etf-lth/nolleblink/2013/hw/nolleblink2013.brd

## EAGLE design 2013/hw/nolleblink2013.brd (2013-07-16)

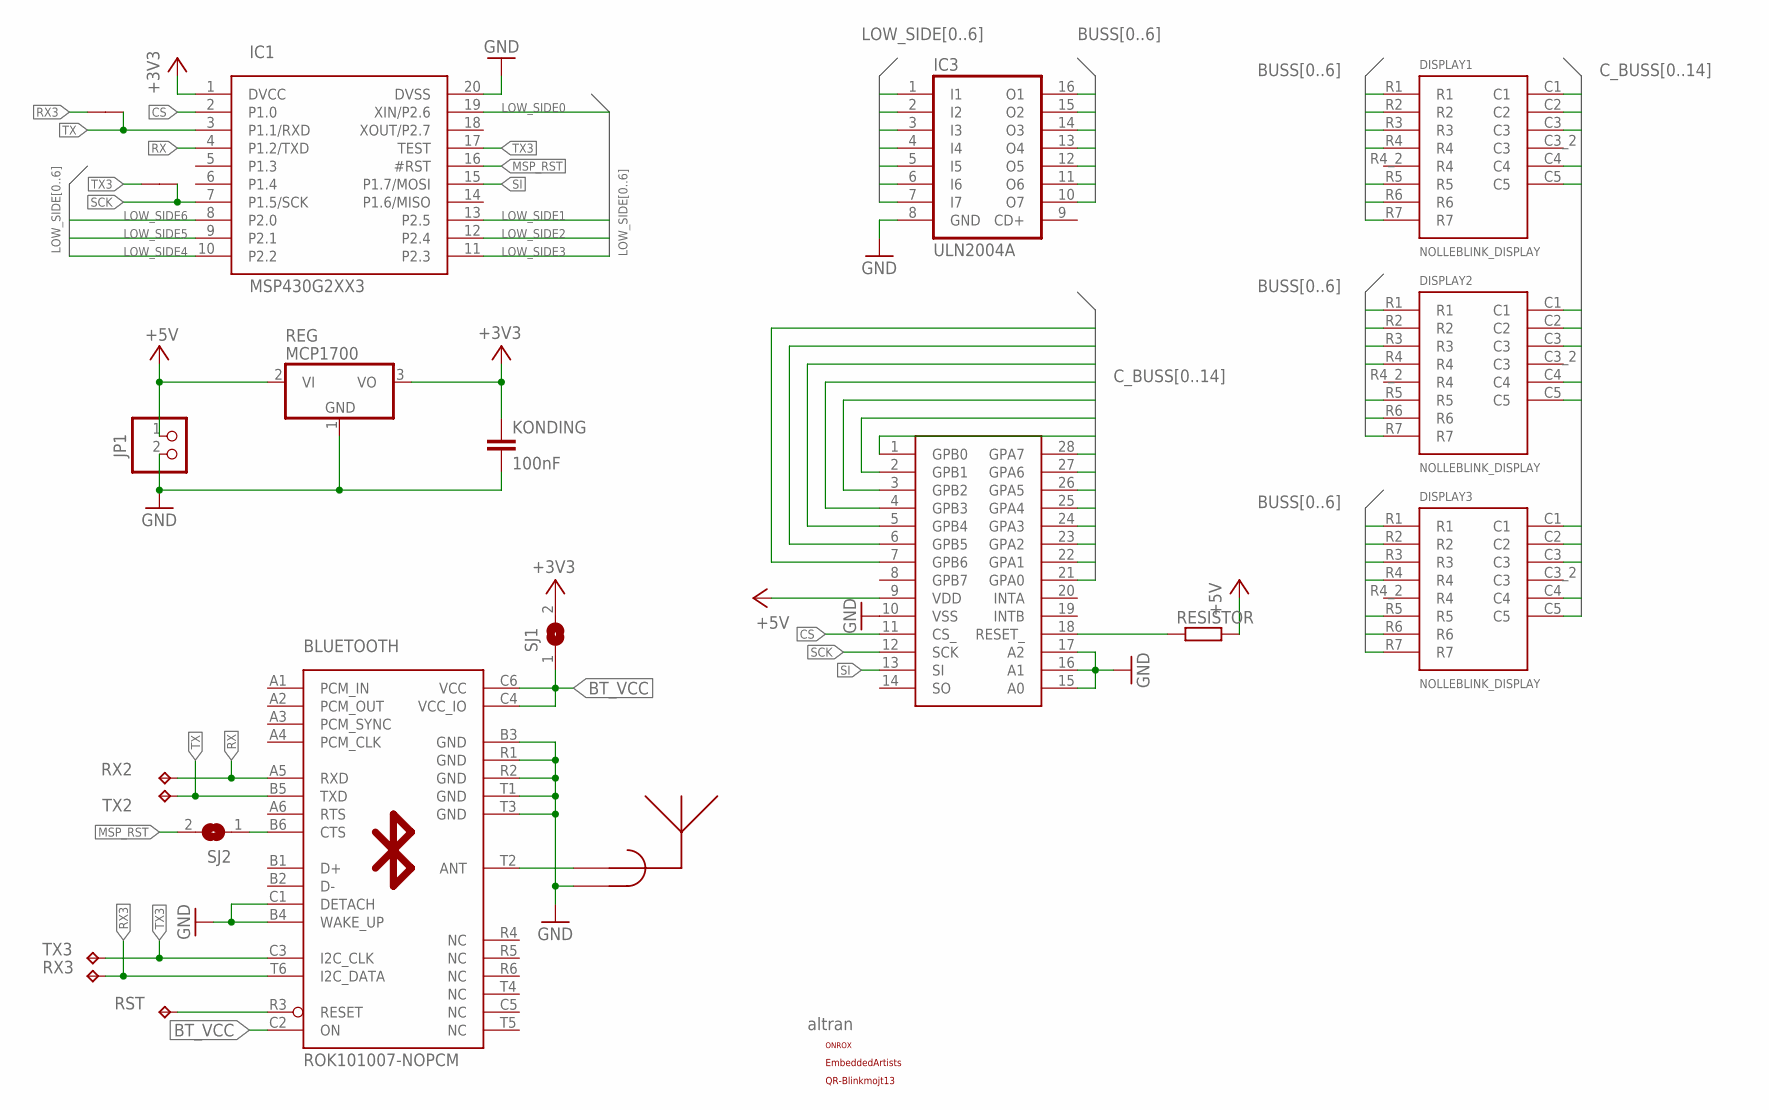
[picture p1: schematic nolleblink2013.sch]

Parts:
BLUETOOTH: ROK101007-NOPCM; ROK101007_NOPCM
DISPLAY1, DISPLAY2, DISPLAY3: NOLLEBLINK_DISPLAY; KINGBRIGHT_TA12-11EWA
IC1: MSP430G2XX3; N20
IC2: MCPS23S17; MCP23S17
IC3: ULN2004A; DIL16
JP1: PINHD-1X2; 1X02
KONDING: 100nF; C050-030X075
REG: MCP1700; TO92_REGULATOR
RESISTOR: R-EU_0207/10; 0207/10
RST: TPTP12SQ; TP12SQ
RX2: TPTP20SQ; TP20SQ
RX3: TPTP12SQ; TP12SQ
SJ1, SJ2: SJ
TX2: TPTP20SQ; TP20SQ
TX3: TPTP12SQ; TP12SQ
U$1: ALTRAN
U$2: ONROX
U$3: INV_F_24; INV_F_ANTENNA
U$4: EMBEDDEDARTISTS
U$5, U$6: JUNCTION
U$7: BLINKMOJT13

Connections:
+3V3: IC1.1 (DVCC), KONDING.1, REG.3 (VO), SJ1.2
+5V: IC2.9 (VDD), JP1.1, REG.2 (VI), RESISTOR.2
BT_VCC: BLUETOOTH.C2 (ON), BLUETOOTH.C4 (VCC_IO), BLUETOOTH.C6 (VCC), SJ1.1
BUSS0: DISPLAY1.R1, DISPLAY2.R1, DISPLAY3.R1, IC3.16 (O1)
BUSS1: DISPLAY1.R2, DISPLAY2.R2, DISPLAY3.R2, IC3.15 (O2)
BUSS2: DISPLAY1.R3, DISPLAY2.R3, DISPLAY3.R3, IC3.14 (O3)
BUSS3: DISPLAY1.R4, DISPLAY2.R4, DISPLAY3.R4, IC3.13 (O4)
BUSS4: DISPLAY1.R5, DISPLAY2.R5, DISPLAY3.R5, IC3.12 (O5)
BUSS5: DISPLAY1.R6, DISPLAY2.R6, DISPLAY3.R6, IC3.11 (O6)
BUSS6: DISPLAY1.R7, DISPLAY2.R7, DISPLAY3.R7, IC3.10 (O7)
CS: IC1.2 (P1.0), IC2.11 (CS_)
C_BUSS0: DISPLAY1.C1, IC2.21 (GPA0)
C_BUSS1: DISPLAY1.C2, IC2.22 (GPA1)
C_BUSS2: DISPLAY1.C3, IC2.23 (GPA2)
C_BUSS3: DISPLAY1.C4, IC2.24 (GPA3)
C_BUSS4: DISPLAY1.C5, IC2.25 (GPA4)
C_BUSS5: DISPLAY2.C1, IC2.26 (GPA5)
C_BUSS6: DISPLAY2.C2, IC2.27 (GPA6)
C_BUSS7: DISPLAY2.C3, IC2.28 (GPA7)
C_BUSS8: DISPLAY2.C4, IC2.1 (GPB0)
C_BUSS9: DISPLAY2.C5, IC2.2 (GPB1)
C_BUSS10: DISPLAY3.C1, IC2.3 (GPB2)
C_BUSS11: DISPLAY3.C2, IC2.4 (GPB3)
C_BUSS12: DISPLAY3.C3, IC2.5 (GPB4)
C_BUSS13: DISPLAY3.C4, IC2.6 (GPB5)
C_BUSS14: DISPLAY3.C5, IC2.7 (GPB6)
GND: BLUETOOTH.B3 (GND), BLUETOOTH.B4 (WAKE_UP), BLUETOOTH.C1 (DETACH), BLUETOOTH.R1 (GND), BLUETOOTH.R2 (GND), BLUETOOTH.T1 (GND), BLUETOOTH.T3 (GND), IC1.20 (DVSS), IC2.10 (VSS), IC2.15 (A0), IC2.16 (A1), IC2.17 (A2), IC3.8 (GND), JP1.2, KONDING.2, REG.1 (GND), U$3.GND
LOW_SIDE0: IC1.19 (XIN/P2.6), IC3.7 (I7)
LOW_SIDE1: IC1.13 (P2.5), IC3.6 (I6)
LOW_SIDE2: IC1.12 (P2.4), IC3.5 (I5)
LOW_SIDE3: IC1.11 (P2.3), IC3.4 (I4)
LOW_SIDE4: IC1.10 (P2.2), IC3.3 (I3)
LOW_SIDE5: IC1.9 (P2.1), IC3.2 (I2)
LOW_SIDE6: IC1.8 (P2.0), IC3.1 (I1)
MSP_RST: IC1.16 (#RST), SJ2.2
unnamed: BLUETOOTH.B6 (CTS), SJ2.1
unnamed: IC2.18 (RESET_), RESISTOR.1
unnamed: BLUETOOTH.T2 (ANT), U$3.FEED (RF)
unnamed: BLUETOOTH.R3 (RESET), RST.TP
RX: BLUETOOTH.A5 (RXD), IC1.4 (P1.2/TXD), RX2.TP
RX3: BLUETOOTH.T6 (I2C_DATA), RX3.TP, U$6.P$2
SCK: IC1.7 (P1.5/SCK), IC2.12 (SCK), U$5.P$1
SI: IC1.15 (P1.7/MOSI), IC2.13 (SI)
TX: BLUETOOTH.B5 (TXD), IC1.3 (P1.1/RXD), TX2.TP, U$6.P$1
TX3: BLUETOOTH.C3 (I2C_CLK), IC1.17 (TEST), TX3.TP, U$5.P$2

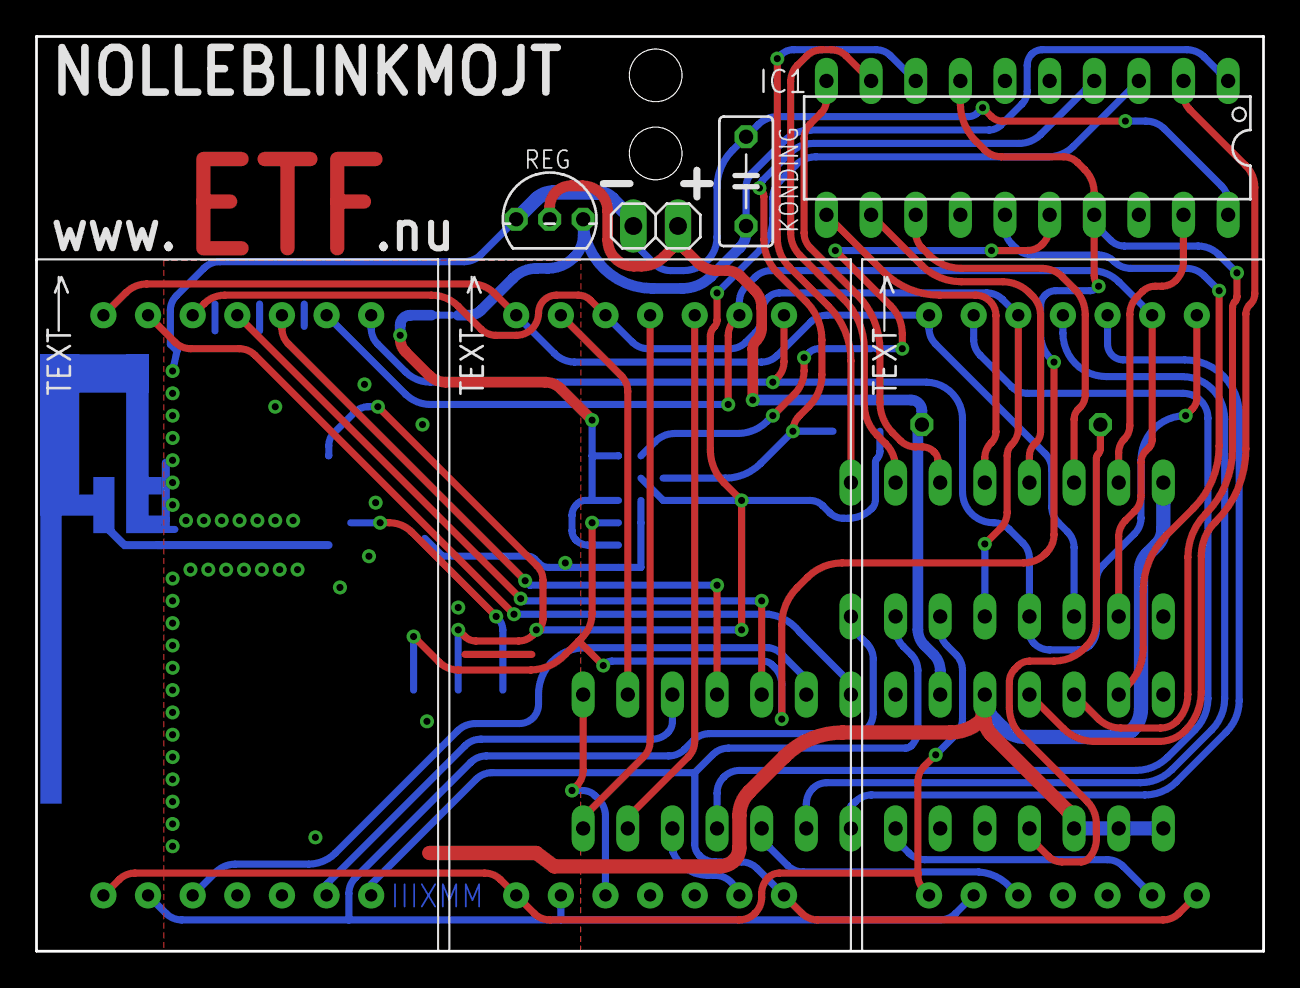
[picture p2: board nolleblink2013.brd from above]

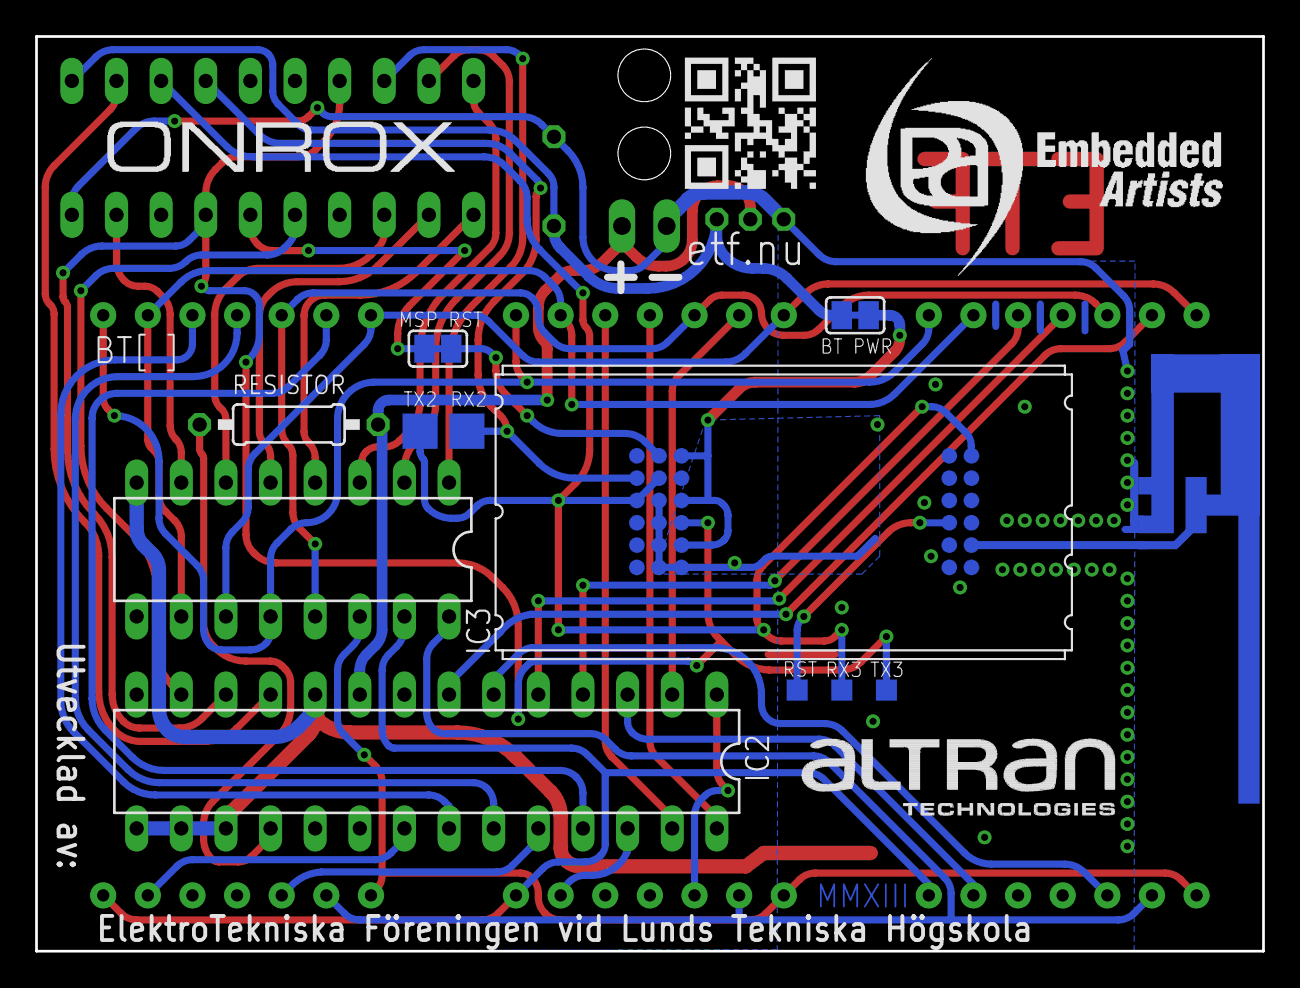
[picture p3: board nolleblink2013.brd from below]

Board: 2 copper layers, 69.8 x 52.1 mm, 25 parts (16 on the bottom side), 45 nets.
