etf-lth/nolleblink/2009/nolleblink09-gnu/ledmatrixascii.h

#include "BinaryNr.h"
//a table that have what pixels to light up in a 5x7 ledmatrix
const unsigned char alfatable[255*5]=
{
		B00000000,
		B00000000,
		B00000000,
		B00000000,
		B00000000,
		
		B00000000,
		B00000000,
		B00000000,
		B00000000,
		B00000000,

		B00000000,
		B00000000,
		B00000000,
		B00000000,
		B00000000,

		B00000000,
		B00000000,
		B00000000,
		B00000000,
		B00000000,

		B00000000,
		B00000000,
		B00000000,
		B00000000,
		B00000000,

		B00000000,
		B00000000,
		B00000000,
		B00000000,
		B00000000,

		B00000000,
		B00000000,
		B00000000,
		B00000000,
		B00000000,

		B00000000,
		B00000000,
		B00000000,
		B00000000,
		B00000000,

		B00000000,
		B00000000,
		B00000000,
		B00000000,
		B00000000,

		B00000000,
		B00000000,
		B00000000,
		B00000000,
		B00000000,

		B00001000,
		B00011100,
		B00101010,
		B01001001,
		B00000000,

		B00011100,
		B00100010,
		B00100010,
		B00100010,
		B00011100,

		B00100010,
		B00100010,
		B00100010,
		B00011100,
		B00000000,

		B00000000,
		B00000000,
		B00000000,
		B00000000,
		B00000000,

		B00000000,
		B00000000,
		B00000000,
		B00000000,
		B00000000,

		B00000000,
		B00000000,
		B00000000,
		B00000000,
		B00000000,

		B00000000,
		B00000000,
		B00000000,
		B00000000,
		B00000000,

		B00000000,
		B00000000,
		B00000000,
		B00000000,
		B00000000,

		B00000000,
		B00000000,
		B00000000,
		B00000000,
		B00000000,

		B00000000,
		B00000000,
		B00000000,
		B00000000,
		B00000000,

		B00000000,
		B00000000,
		B00000000,
		B00000000,
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
		B00000000,
		B00000000,

		B00000000,
		B00010010,
		B00011111,
		B00010000,
		B00000000,

		B00000000,
		B00010001,
		B00010101,
		B00001010,
		B00000000,

		B00010010,
		B00011001,
		B00010101,
		B00010010,
		B00000000,

		B00000000,
		B00011100,
		B00011100,
		B00011100,
		B00000000
};
