etf-lth/nolleblink/2013/fw/ledfont.c

/*
 *  ledfont.c
 *  Nolleblink 2010 | Blinkmojt
 *
 *  Modified by Fredrik Ahlberg on 2010-06-25.
 *  Original implementation by Joakim Arnsby.
 *  Copyright (c) 2009 - 2010 ETF. All rights reserved.
 *
 */

#include "ledfont.h"

/* PURE EVIL OF DOOOM! */
#define X )<<1|1
#define _ )<<1
#define s ((((((((0

const unsigned char smallfont[255*5] =
{
  s _ _ _ _ _ _ _ _,
  s _ _ _ _ _ _ _ _,
  s _ _ _ _ _ _ _ _,
  s _ _ _ _ _ _ _ _,
  s _ _ _ _ _ _ _ _,
  
  s _ _ _ _ _ _ _ _ ,
  s _ _ _ _ _ _ _ _ ,
  s _ _ _ _ _ _ _ _ ,
  s _ _ _ _ _ _ _ _ ,
  s _ _ _ _ _ _ _ _ ,
  
  s _ _ _ _ _ _ _ _ ,
  s _ _ _ _ _ _ _ _ ,
  s _ _ _ _ _ _ _ _ ,
  s _ _ _ _ _ _ _ _ ,
  s _ _ _ _ _ _ _ _ ,
  
  s _ _ _ _ _ _ _ _ ,
  s _ _ _ _ _ _ _ _ ,
  s _ _ _ _ _ _ _ _ ,
  s _ _ _ _ _ _ _ _ ,
  s _ _ _ _ _ _ _ _ ,
  
  s _ _ _ _ _ _ _ _ ,
  s _ _ _ _ _ _ _ _ ,
  s _ _ _ _ _ _ _ _ ,
  s _ _ _ _ _ _ _ _ ,
  s _ _ _ _ _ _ _ _ ,
  
  s _ _ _ _ _ _ _ _ ,
  s _ _ _ _ _ _ _ _ ,
  s _ _ _ _ _ _ _ _ ,
  s _ _ _ _ _ _ _ _ ,
  s _ _ _ _ _ _ _ _ ,
  
  s _ _ _ _ _ _ _ _ ,
  s _ _ _ _ _ _ _ _ ,
  s _ _ _ _ _ _ _ _ ,
  s _ _ _ _ _ _ _ _ ,
  s _ _ _ _ _ _ _ _ ,
  
  s _ _ _ _ _ _ _ _ ,
  s _ _ _ _ _ _ _ _ ,
  s _ _ _ _ _ _ _ _ ,
  s _ _ _ _ _ _ _ _ ,
  s _ _ _ _ _ _ _ _ ,
  
  s _ _ _ _ _ _ _ _ ,
  s _ _ _ _ _ _ _ _ ,
  s _ _ _ _ _ _ _ _ ,
  s _ _ _ _ _ _ _ _ ,
  s _ _ _ _ _ _ _ _ ,
  
  s _ _ _ _ _ _ _ _ ,
  s _ _ _ _ _ _ _ _ ,
  s _ _ _ _ _ _ _ _ ,
  s _ _ _ _ _ _ _ _ ,
  s _ _ _ _ _ _ _ _ ,
  
  s _ _ _ _ X _ _ _ ,
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
  s _ _ _ X _ X _ X ,
  s _ _ _ _ X _ X _ ,
  s _ _ _ _ _ _ _ _ ,

  s _ _ _ X _ _ X _ ,
  s _ _ _ X X _ _ X ,
  s _ _ _ X _ X _ X ,
  s _ _ _ X _ _ X _ ,
  s _ _ _ _ _ _ _ _ ,

  s _ _ _ _ _ _ _ _ ,
  s _ _ _ X X X _ _ ,
  s _ _ _ X X X _ _ ,
  s _ _ _ X X X _ _ ,
  s _ _ _ _ _ _ _ _ 
};
