etf-lth/nolleblink/2009/nolleblink09-gnu/BinaryNr.h

// ===========================================================================

/*! \file BinaryNr.h
    \brief Preprocessor defines for binary numbers from 0 to 255
*/
// ===========================================================================

#ifndef USE_BINARYNR_H
#define USE_BINARYNR_H

#define B00000000 0x00
#define B00000001 0x01
#define B00000010 0x02
#define B00000011 0x03
#define B00000100 0x04
#define B00000101 0x05
#define B00000110 0x06
#define B00000111 0x07
#define B00001000 0x08
#define B00001001 0x09
#define B00001010 0x0A
#define B00001011 0x0B
#define B00001100 0x0C
#define B00001101 0x0D
#define B00001110 0x0E
#define B00001111 0x0F
#define B00010000 0x10
#define B00010001 0x11
#define B00010010 0x12
#define B00010011 0x13
#define B00010100 0x14
#define B00010101 0x15
#define B00010110 0x16
#define B00010111 0x17
#define B00011000 0x18
#define B00011001 0x19
#define B00011010 0x1A
#define B00011011 0x1B
#define B00011100 0x1C
#define B00011101 0x1D
#define B00011110 0x1E
#define B00011111 0x1F
#define B00100000 0x20
#define B00100001 0x21
#define B00100010 0x22
#define B00100011 0x23
#define B00100100 0x24
#define B00100101 0x25
#define B00100110 0x26
#define B00100111 0x27
#define B00101000 0x28
#define B00101001 0x29
#define B00101010 0x2A
#define B00101011 0x2B
#define B00101100 0x2C
#define B00101101 0x2D
#define B00101110 0x2E
#define B00101111 0x2F
#define B00110000 0x30
#define B00110001 0x31
#define B00110010 0x32
#define B00110011 0x33
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
#define B11101010 0xEA
#define B11101011 0xEB
#define B11101100 0xEC
#define B11101101 0xED
#define B11101110 0xEE
#define B11101111 0xEF
#define B11110000 0xF0
#define B11110001 0xF1
#define B11110010 0xF2
#define B11110011 0xF3
#define B11110100 0xF4
#define B11110101 0xF5
#define B11110110 0xF6
#define B11110111 0xF7
#define B11111000 0xF8
#define B11111001 0xF9
#define B11111010 0xFA
#define B11111011 0xFB
#define B11111100 0xFC
#define B11111101 0xFD
#define B11111110 0xFE
#define B11111111 0xFF

#endif
