etf-lth/nolleblink/(commit log)

2012-07-17 2010 hw
    [nolleblink2010_final.brd, nolleblink2010_final.sch]
2012-07-17 2009 hw
    [nolleblink2009_final.brd, nolleblink2009_final.sch]
2012-07-17 hw initial
    [nolleblink2012_final.brd, nolleblink2012_final.sch]
2012-07-26 2012 hw
    [nolleblink2012_final.brd, nolleblink2012_final.sch]
2012-07-26 2012 hw final?
    [nolleblink2012_final.brd, nolleblink2012_final.sch]
2012-08-14 added notes to 2012 hw
    [nolleblink2012_final.sch]
2012-10-01 pogo board for 2012 hw
    [nolleblink2012_final.brd, nolleblink2012_final.sch]
2013-07-16 2013 hw done?
    [nolleblink2013.brd, nolleblink2013.sch]
2013-08-25 deferred uart handling with fifo
2013-08-25 reduced led duty cycle
